thomasfredericks/EuroESP32/README.md

# EuroESP32
 Eurorack version of the ESP32 made to develop modules.

## Features
* 2x audio in 24bits
* 2x audio out 24bits
* 4x CV in (-5V to 5V) 12bits
* 4x CV out (0V to 5V) 12bits
