thomasfredericks/EuroESP32/EuroESP32-BOM.txt

Partlist exported from C:/Users/tofredericks/OneDrive/Création/Eurorack Circuits/EuroESP32/EuroESP32.sch at 2021-03-19 12:49

Qty Value                    Device                   Package             Parts                                                      Description                AVAILABILITY DESCRIPTION                                   MF                   MP           MPN           OC_FARNELL OC_NEWARK PACKAGE          POPULARITY PRICE PURCHASE-URL                                                  SUPPLIER 
1                            CRYSTAL                  HC49UP              Q1                                                                                                                                                                                                                                                                                                                             
2                            DIODE                    SOD123              D1, D2                                                                                                                                                                                                                                                                                                                         
1   +12V                     HEADER-1X1               1X01_SIDE_NAME      +12V                                                       Header 1                                                                                                                                                                                                                                                            
1   +3.3VA                   HEADER-1X1               1X01_SIDE_NAME      +3.3VA                                                     Header 1                                                                                                                                                                                                                                                            
1   -10VREF                  HEADER-1X1               1X01_SIDE_NAME      -10VREF                                                    Header 1                                                                                                                                                                                                                                                            
1   -12V                     HEADER-1X1               1X01_SIDE_NAME      -12V                                                       Header 1                                                                                                                                                                                                                                                            
8   100k                     RESISTOR                 RESISTOR_0603       R20, R21, R25, R26, R30, R31, R36, R37                                                                                                                                                                                                                                                                                         
12  100nF                    CAPACITOR                RESISTOR_0603       C14, C16, C17, C18, C19, C20, C27, C29, C30, C44, C46, C57                                                                                                                                                                                                                                                                     
2   10uF                     C2.5/2                   C2.5-2              C1, C6                                                     CAPACITOR                                                                                                                                                                                                                                                           
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
1   LOUT                     HEADER-1X1               1X01_SIDE_NAME      J_LOUT                                                     Header 1                                                                                                                                                                                                                                                            
1   MCP3204-CI/SL            MCP3204-CI/SL            SOIC127P600X175-14N U2                                                         IC ADC 12BIT 2.7V 4CH SPI                                                                                               MCP3204-CI/SL 1196795    26M1276   14 - SOIC                                                                                       Microchip
2   MCP4822-E/MS             MCP4822-E/MS             SOP65P490X110-8N    U$1, U$2                                                   Check prices               Warning       12 Bit Digital to Analog Converter 2 8-MSOP  Microchip Technology MCP4822-E/MS                                    MSOP-8 Microchip            None  https://pricing.snapeda.com/search/part/MCP4822-E/MS/?ref=eda          
1   MCP6004                  OPAMP_QUADPWR            TSSOP14             IC10                                                                                                                                                                                                                                                                                                                           
5   PCB_SCREW                PCB_SCREW                PCB_SCREW           H1, H2, H3, H4, H5                                                                                                                                                                                                                                                                                                             
1   POWER_SIMPLE10           POWER_SIMPLE10           POWER_10            P4                                                                                                                                                                                                                                                                                                                             
1   RIN                      HEADER-1X1               1X01_SIDE_NAME      J_RIN                                                      Header 1                                                                                                                                                                                                                                                            
1   ROUT                     HEADER-1X1               1X01_SIDE_NAME      J_ROUT                                                     Header 1                                                                                                                                                                                                                                                            
2   TL072                    OPAMP_DUAL               SOIC8               IC2, IC3                                                                                                                                                                                                                                                                                                                       
2   TL074D                   TL074D                   SO14                IC1, IC5                                                   OP AMP                                                                                                                                                                      0                                                                                       
1   WM8731                   WM8731                   SSOP28              IC4
