thomasfredericks/EuroESP32/EuroESP32_bottom_parts.pdf

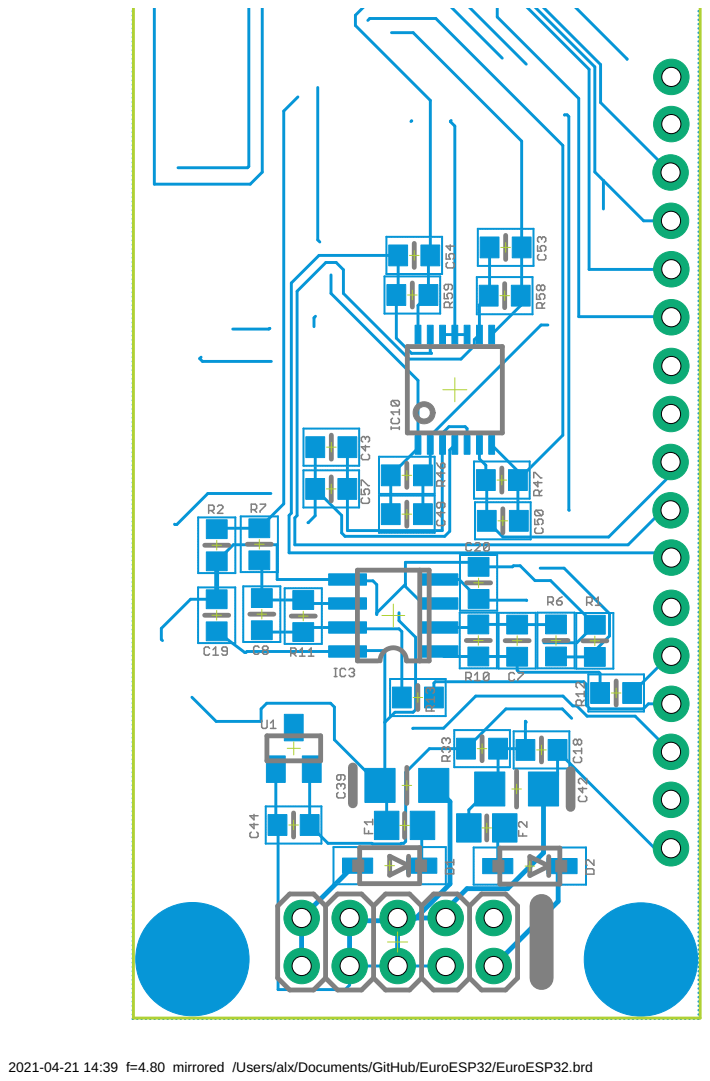
[picture p1: page 1]

2021-04-21 14:39 f=4.80 mirrored /Users/alx/Documents/GitHub/EuroESP32/EuroESP32.brd

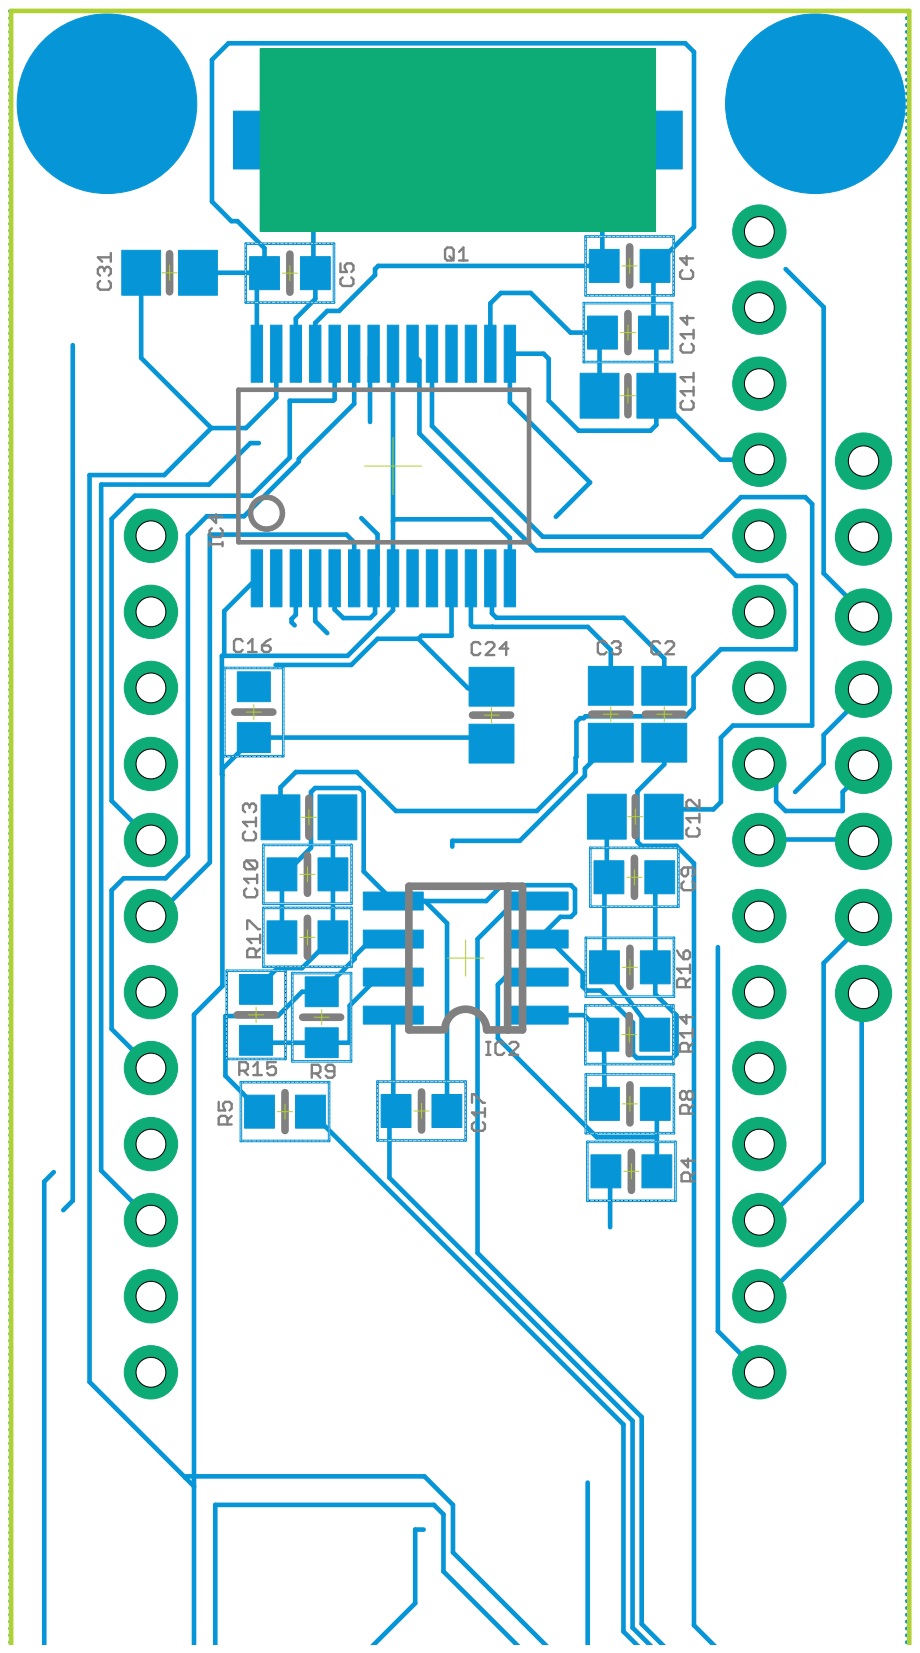
[picture p2: page 2]
