thomasfredericks/EuroESP32/EuroESP32_top_parts.pdf

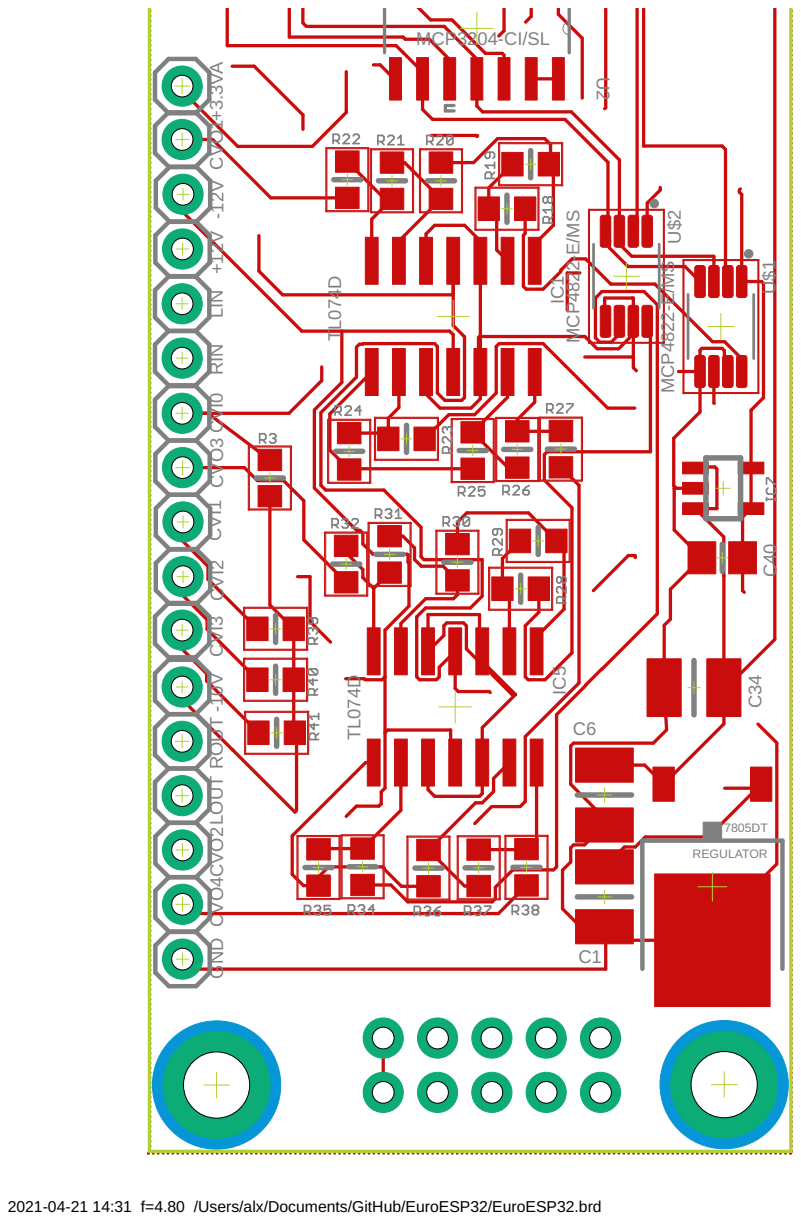
[picture p3: page 1]

2021-04-21 14:31 f=4.80 /Users/alx/Documents/GitHub/EuroESP32/EuroESP32.brd

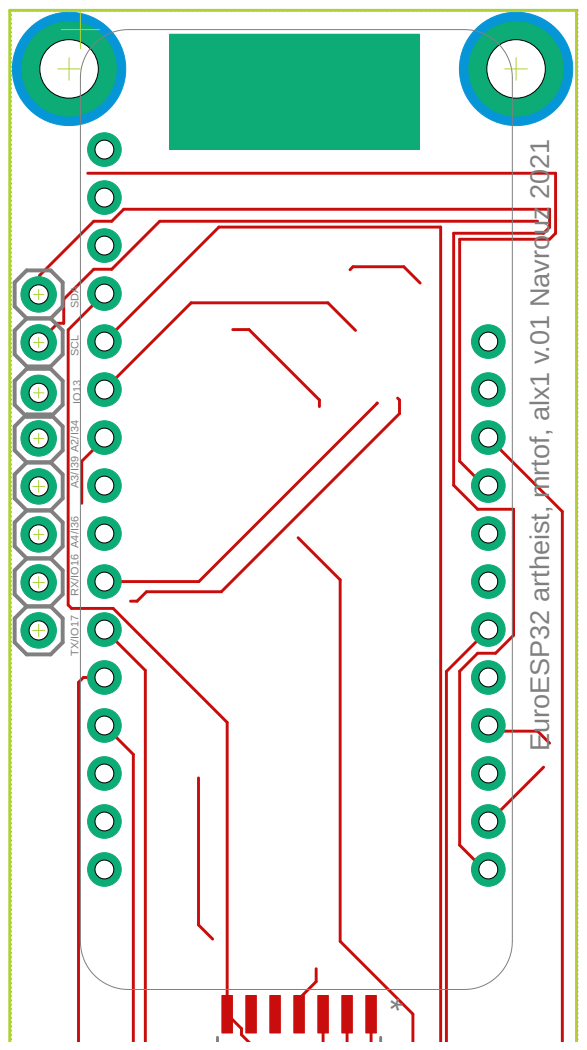
[picture p4: page 2]
