thomasfredericks/EuroESP32/EuroESP32.brd

## EAGLE design EuroESP32.brd (2021-04-21)

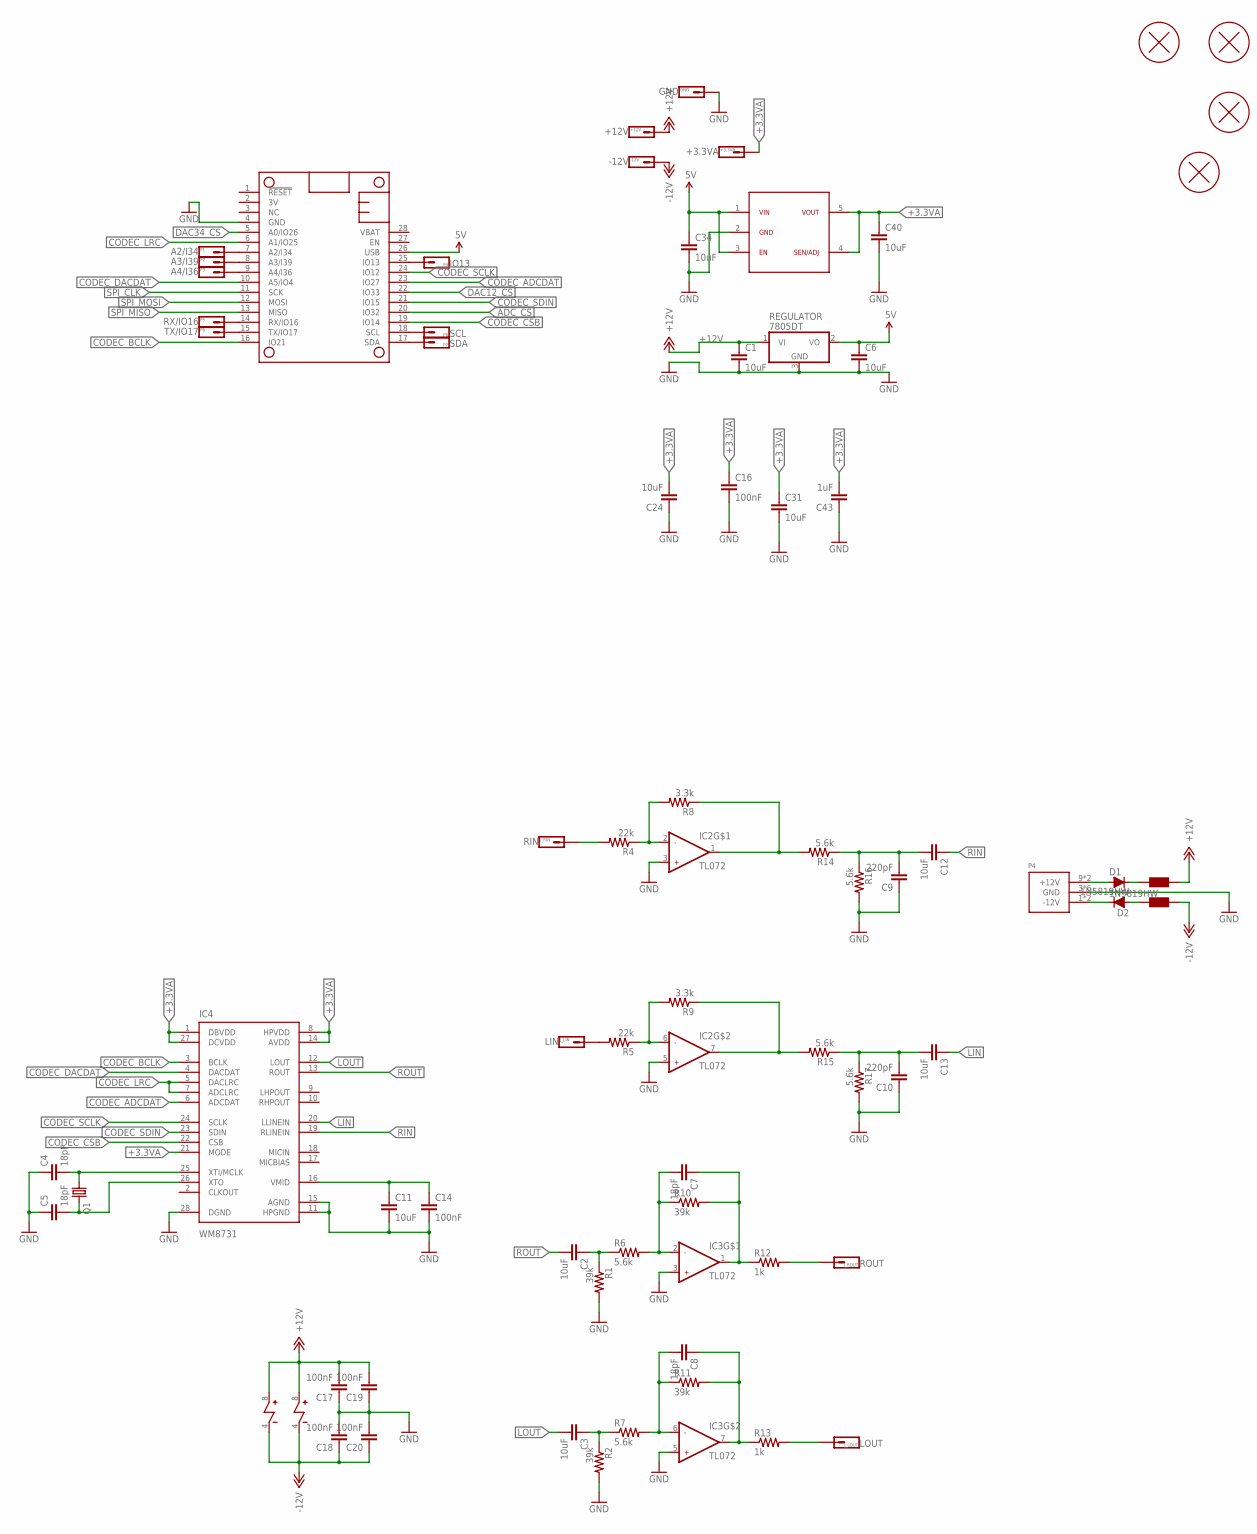
[picture p5: schematic EuroESP32.sch, part in row 1, column 1]

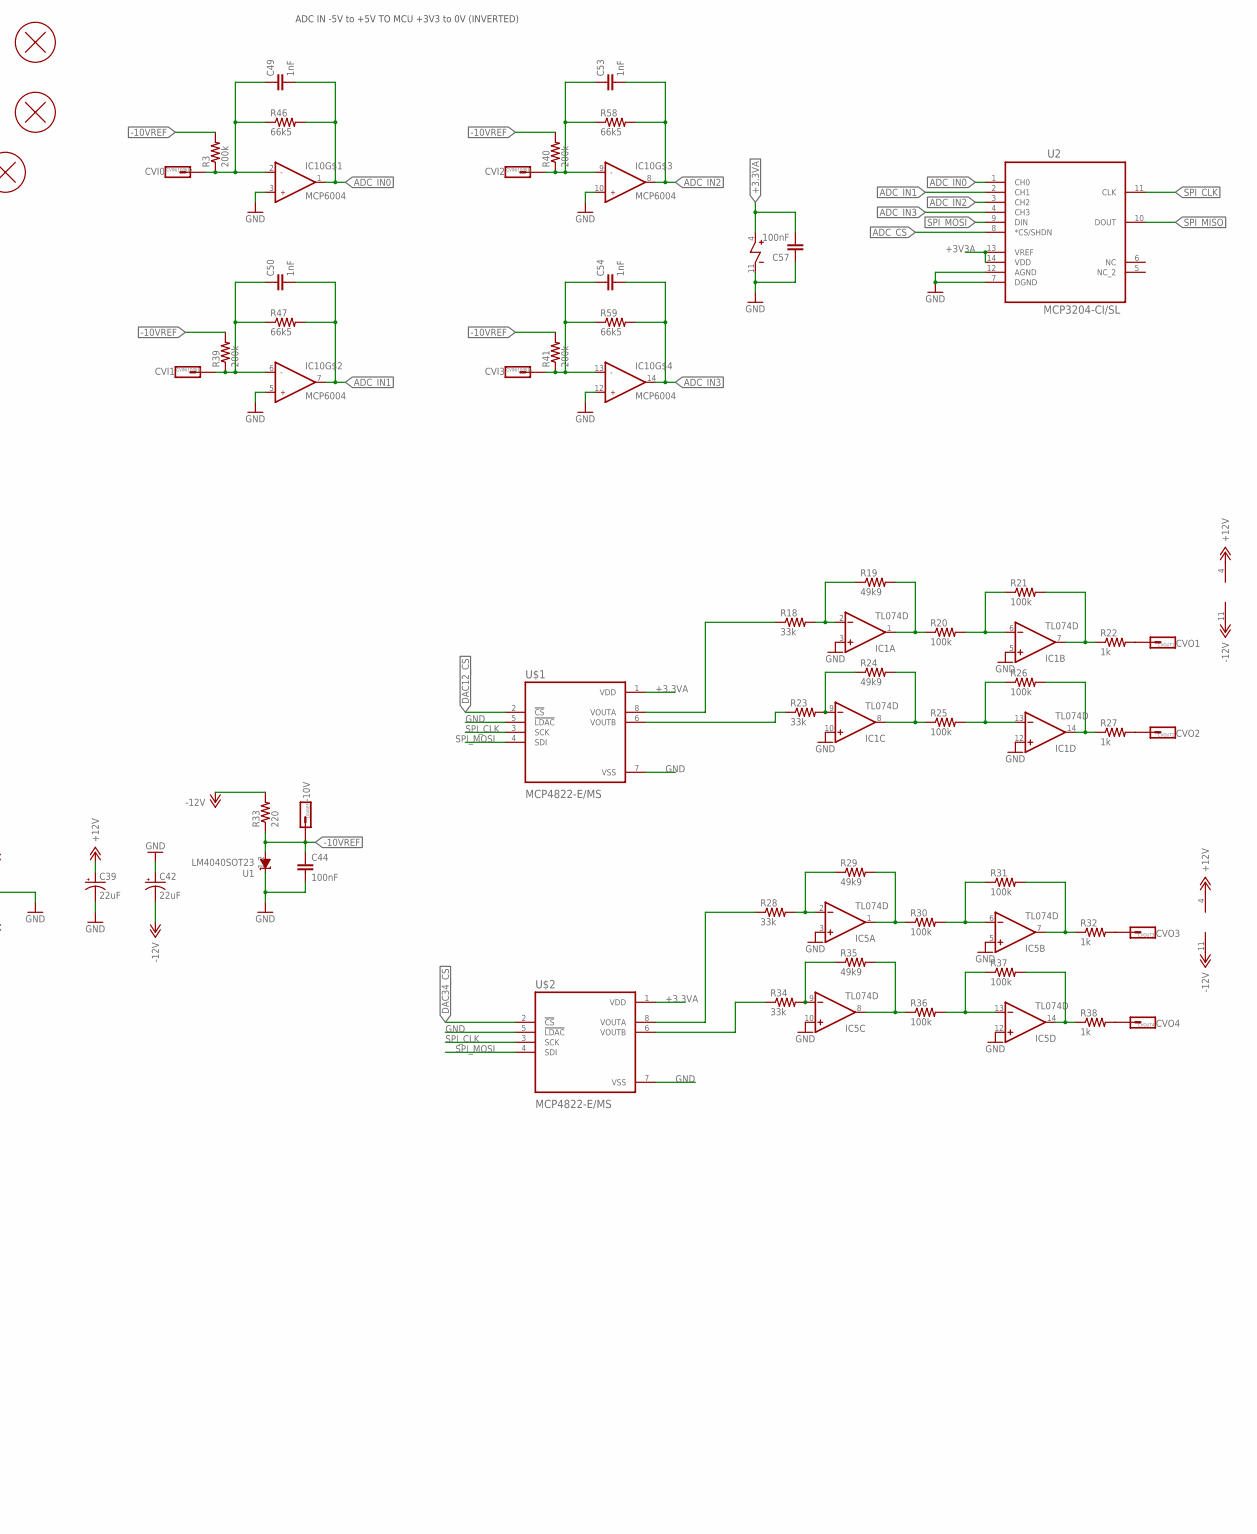
[picture p6: schematic EuroESP32.sch, part in row 1, column 2]

Parts:
+3.3VA: +3.3VA; 1X01_SIDE_NAME
+12V: +12V; 1X01_SIDE_NAME
-10VREF: -10V; 1X01_SIDE_NAME
-12V: -12V; 1X01_SIDE_NAME
C1, C6, C34: 10uF; R1210
C2, C3, C11, C12, C13, C24, C31, C40: 10uF; R0805
C4, C5, C7, C8: 18pF; RESISTOR_0603
C9, C10: 220pF; RESISTOR_0603
C14, C16, C17, C18, C19, C20, C44, C57: 100nF; RESISTOR_0603
C39, C42: 22uF; 1206_POL
C43: 1uF; RESISTOR_0603
C49, C50, C53, C54: 1nF; RESISTOR_0603
CVIN(100K)0: CVI0; 1X01_SIDE_NAME
CVIN(100K)1: CVI1; 1X01_SIDE_NAME
CVIN(100K)2: CVI2; 1X01_SIDE_NAME
CVIN(100K)3: CVI3; 1X01_SIDE_NAME
CVOUT1: CVO1; 1X01_SIDE_NAME
CVOUT2: CVO2; 1X01_SIDE_NAME
CVOUT3: CVO3; 1X01_SIDE_NAME
CVOUT4: CVO4; 1X01_SIDE_NAME
D1, D2: 1N5819HW; SOD123
F1, F2: Würth Electronics 742792664; R0805
GND: GND; 1X01_SIDE_NAME
H1, H3, H4, H5: PCB_SCREW
IC1, IC5: TL074D; SO14
IC2, IC3: TL072; SOIC8
IC4: WM8731; SSOP28
IC7: ADP7118; SOT23-5L
IC10: MCP6004; TSSOP14
J_LIN: LIN; 1X01_SIDE_NAME
J_LOUT: LOUT; 1X01_SIDE_NAME
J_RIN: RIN; 1X01_SIDE_NAME
J_ROUT: ROUT; 1X01_SIDE_NAME
MS2: FEATHER_HUZZAH32NO_DRILL; FEATHERWING_NODRILL
P1: A2/I34; 1X01_SIDE_NAME
P2: A3/I39; 1X01_SIDE_NAME
P3: A4/I36; 1X01_SIDE_NAME
P4: POWER_SIMPLE10; POWER_10
P5: RX/IO16; 1X01_SIDE_NAME
P6: TX/IO17; 1X01_SIDE_NAME
P7: SDA; 1X01_SIDE_NAME
P8: SCL; 1X01_SIDE_NAME
P9: IO13; 1X01_SIDE_NAME
Q1: CRYSTAL; HC49UP
R1, R2, R10, R11: 39k; RESISTOR_0603
R3, R39, R40, R41: 200k; RESISTOR_0603
R4, R5: 22k; RESISTOR_0603
R6, R7, R14, R15, R16, R17: 5.6k; RESISTOR_0603
R8, R9: 3.3k; RESISTOR_0603
R12, R13, R22, R27, R32, R38: 1k; RESISTOR_0603
R18, R23, R28, R34: 33k; RESISTOR_0603
R19, R24, R29, R35: 49k9; RESISTOR_0603
R20, R21, R25, R26, R30, R31, R36, R37: 100k; RESISTOR_0603
R33: 220; RESISTOR_0603
R46, R47, R58, R59: 66k5; RESISTOR_0603
REGULATOR: 7805DT; TO252
U1: LM4040SOT23; SOT23
U2: MCP3204-CI/SL; SOIC127P600X175-14N
U$1, U$2: MCP4822-E/MS; SOP65P490X110-8N

Connections:
5V: C6.1, C34.1, IC7.1, IC7.3, MS2.26 (USB), REGULATOR.2 (VO)
+3.3VA: +3.3VA.1, C16.1, C24.2, C31.1, C40.1, C43.2, C57.2, IC4.1 (DBVDD), IC4.8 (HPVDD), IC4.14 (AVDD), IC4.21 (MODE), IC4.27 (DCVDD), IC7.4, IC7.5, IC10.4, U$1.1 (VDD), U$2.1 (VDD)
+3V3A: U2.13 (VREF), U2.14 (VDD)
+12V: +12V.1, C1.1, C17.2, C19.2, C39.2 (+), F1.1, IC1.4 (V+), IC2.8, IC3.8, IC5.4 (V+), REGULATOR.1 (VI)
-10VREF: -10VREF.1, C44.1, R3.2, R33.1, R39.2, R40.2, R41.2, U1.2 (A)
-12V: -12V.1, C18.1, C20.1, C42.1 (-), F2.1, IC1.11 (V-), IC2.4, IC3.4, IC5.11 (V-), R33.2
ADC_CS: MS2.20 (IO32), U2.8 (*CS/SHDN)
ADC_IN0: C49.2, IC10.1, R46.2, U2.1 (CH0)
ADC_IN1: C50.2, IC10.7, R47.2, U2.2 (CH1)
ADC_IN2: C53.2, IC10.8, R58.2, U2.3 (CH2)
ADC_IN3: C54.2, IC10.14, R59.2, U2.4 (CH3)
CODEC_ADCDAT: IC4.6 (ADCDAT), MS2.23 (IO27)
CODEC_BCLK: IC4.3 (BCLK), MS2.16 (IO21)
CODEC_CSB: IC4.22 (CSB), MS2.19 (IO14)
CODEC_DACDAT: IC4.4 (DACDAT), MS2.10 (A5/IO4)
CODEC_LRC: IC4.5 (DACLRC), IC4.7 (ADCLRC), MS2.6 (A1/IO25)
CODEC_SCLK: IC4.24 (SCLK), MS2.24 (IO12)
CODEC_SDIN: IC4.23 (SDIN), MS2.21 (IO15)
DAC12_CS: MS2.22 (IO33), U$1.2 (!CS)
DAC34_CS: MS2.5 (A0/IO26), U$2.2 (!CS)
DAC_B: R23.1, U$1.6 (VOUTB)
DAC_D: R34.1, U$2.6 (VOUTB)
GND: C1.2, C4.1, C5.1, C6.2, C9.1, C10.1, C11.2, C14.2, C16.2, C17.1, C18.2, C19.1, C20.2, C24.1, C31.2, C34.2, C39.1 (-), C40.2, C42.2 (+), C43.1, C44.2, C57.1, GND.1, IC1.3 (+IN), IC1.5 (+IN), IC1.10 (+IN), IC1.12 (+IN), IC2.3, IC2.5, IC3.3, IC3.5, IC4.11 (HPGND), IC4.15 (AGND), IC4.28 (DGND), IC5.3 (+IN), IC5.5 (+IN), IC5.10 (+IN), IC5.12 (+IN), IC7.2, IC10.3, IC10.5, IC10.10, IC10.11, IC10.12, MS2.4 (GND), P4.3 (GND), P4.4 (GND), P4.5 (GND), P4.6 (GND), P4.7 (GND), P4.8 (GND), R1.2, R2.2, R16.2, R17.2, REGULATOR.3 (GND), U1.1 (C), U2.7 (DGND), U2.12 (AGND), U$1.5 (!LDAC), U$1.7 (VSS), U$2.5 (!LDAC), U$2.7 (VSS)
LIN: C13.1, IC4.20 (LLINEIN)
LOUT: C3.2, IC4.12 (LOUT)
unnamed: J_LIN.1, R5.2
unnamed: J_LOUT.1, R13.2
unnamed: J_ROUT.1, R12.2
unnamed: IC1.2 (-IN), R18.2, R19.1
unnamed: IC1.7 (OUT), R21.2, R22.1
unnamed: IC1.9 (-IN), R23.2, R24.1
unnamed: MS2.7 (A2/I34), P1.1
unnamed: IC1.1 (OUT), R19.2, R20.1
unnamed: IC1.14 (OUT), R26.2, R27.1
unnamed: IC5.6 (-IN), R30.2, R31.1
unnamed: IC1.8 (OUT), R24.2, R25.1
unnamed: IC5.2 (-IN), R28.2, R29.1
unnamed: IC5.7 (OUT), R31.2, R32.1
unnamed: IC5.13 (-IN), R36.2, R37.1
unnamed: C53.1, CVIN(100K)2.1, IC10.9, R40.1, R58.1
unnamed: IC5.1 (OUT), R29.2, R30.1
unnamed: C49.1, CVIN(100K)0.1, IC10.2, R3.1, R46.1
unnamed: IC5.9 (-IN), R34.2, R35.1
unnamed: C50.1, CVIN(100K)1.1, IC10.6, R39.1, R47.1
unnamed: IC5.14 (OUT), R37.2, R38.1
unnamed: C54.1, CVIN(100K)3.1, IC10.13, R41.1, R59.1
unnamed: IC1.6 (-IN), R20.2, R21.1
unnamed: IC5.8 (OUT), R35.2, R36.1
unnamed: R18.1, U$1.8 (VOUTA)
unnamed: CVOUT1.1, R22.2
unnamed: R28.1, U$2.8 (VOUTA)
unnamed: CVOUT2.1, R27.2
unnamed: IC1.13 (-IN), R25.2, R26.1
unnamed: CVOUT3.1, R32.2
unnamed: MS2.8 (A3/I39), P2.1
unnamed: J_RIN.1, R4.2
unnamed: IC2.2, R4.1, R8.2
unnamed: D1.+, P4.9 (+12V), P4.10 (+12V)
unnamed: CVOUT4.1, R38.2
unnamed: MS2.9 (A4/I36), P3.1
unnamed: IC2.1, R8.1, R14.2
unnamed: C9.2, C12.2, R14.1, R16.1
unnamed: MS2.14 (RX/IO16), P5.1
unnamed: MS2.15 (TX/IO17), P6.1
unnamed: IC2.6, R5.1, R9.2
unnamed: MS2.17 (SDA), P7.1
unnamed: IC2.7, R9.1, R15.2
unnamed: C5.2, IC4.26 (XTO), Q1.2
unnamed: C4.2, IC4.25 (XTI/MCLK), Q1.1
unnamed: C10.2, C13.2, R15.1, R17.1
unnamed: C7.1, IC3.1, R10.2, R12.1
unnamed: D1.-, F1.2
unnamed: C7.2, IC3.2, R6.2, R10.1
unnamed: C2.1, R1.1, R6.1
unnamed: MS2.18 (SCL), P8.1
unnamed: MS2.25 (IO13), P9.1
unnamed: D2.-, P4.1 (-12V), P4.2 (-12V)
unnamed: C8.1, IC3.7, R11.2, R13.1
unnamed: C8.2, IC3.6, R7.2, R11.1
unnamed: C11.1, C14.1, IC4.16 (VMID)
unnamed: C3.1, R2.1, R7.1
unnamed: D2.+, F2.2
RIN: C12.1, IC4.19 (RLINEIN)
ROUT: C2.2, IC4.13 (ROUT)
SPI_CLK: MS2.11 (SCK), U2.11 (CLK), U$1.3 (SCK), U$2.3 (SCK)
SPI_MISO: MS2.13 (MISO), U2.10 (DOUT)
SPI_MOSI: MS2.12 (MOSI), U2.9 (DIN), U$1.4 (SDI), U$2.4 (SDI)

Notes on the sheet:
ADC IN -5V to +5V TO MCU +3V3 to 0V (INVERTED)

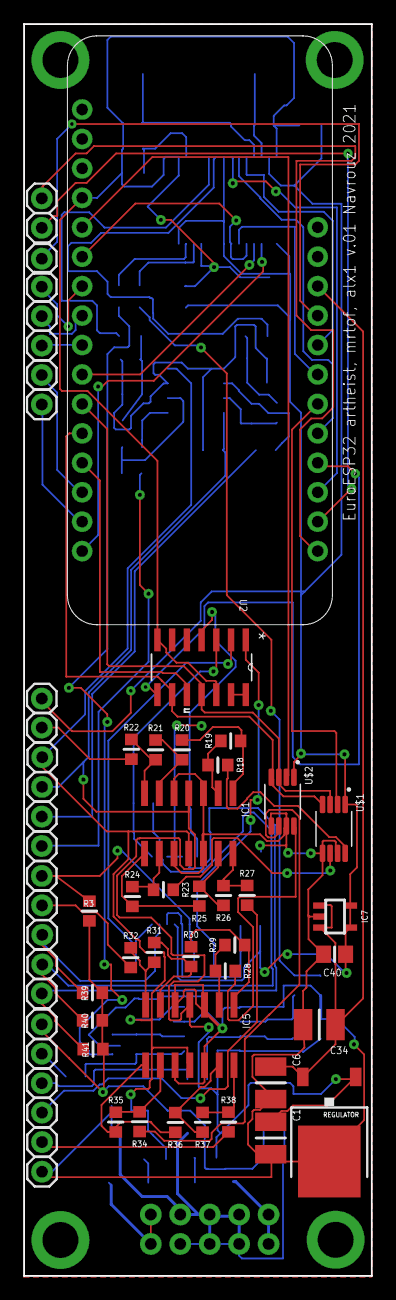
[picture p7: board EuroESP32.brd from above]

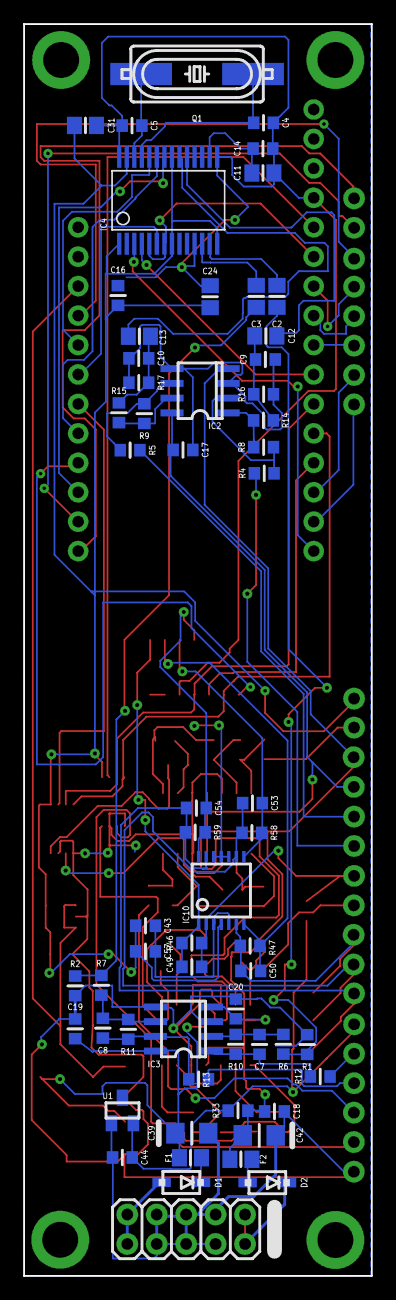
[picture p8: board EuroESP32.brd from below]

Board: 2 copper layers, 30.0 x 108.0 mm, 125 parts (60 on the bottom side), 87 nets.
