thomasfredericks/EuroESP32/(commit log)

2021-03-19 A few corrections
    [EuroESP32.brd, EuroESP32.sch]
2021-03-21 Added groups in schematic
    [EuroESP32.brd, EuroESP32.sch]
2021-03-21 Changed voltage regulator
    [EuroESP32.brd, EuroESP32.sch]
2021-03-22 Added groups and merged changes from alx-1
    [EuroESP32.brd, EuroESP32.sch]
2021-03-22 Moved connecters to the side
    [EuroESP32.brd]
2021-03-22 Update EuroESP32.brd
    v0.2
    Proper spacing for the main connector
    [EuroESP32.brd]
2021-03-22 Create EuroESP32_2021-03-22.zip
    For board houses
2021-03-23 Added extra connectors
    [EuroESP32.brd, EuroESP32.sch]
2021-03-23 Added a little information
    [EuroESP32.brd, EuroESP32.sch]
2021-03-23 Just names and a date
    [EuroESP32.brd]
2021-04-21 Lower board (not the top panel)
    [EURO32_lower.brd, EURO32_lower.sch, EuroESP32.brd]
2021-04-22 Updated BOM
    [EuroESP32-BOM-Digikey.csv]
